lifetyper/smart_line/README.md

就是个通过FT232H芯片，把USB转成SPI、I2C用于硬件调试的小工具，软件使用的是pyftdi。

第一版硬件有点小bug，但实际上使用时并不表现出来。

第二版改成kicad的开源工具了，很难用，所以凑合着用4层板画比较简单，反正嘉立创现在4层板才50块钱。。。。
