lifetyper/smart_line/layout/smart_line_x01_Board_Outline.pdf

ART FILM - Board_Outline

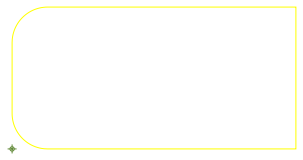
[picture p1: figure]

ART FILM - Board_Outline
