lifetyper/smart_line/layout/smart_line_x01_MASK_BOT.pdf

ART FILM - MASK_BOT

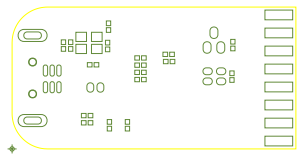
[picture p2: figure]

ART FILM - MASK_BOT
