lifetyper/smart_line/datasheet/adafruit.png

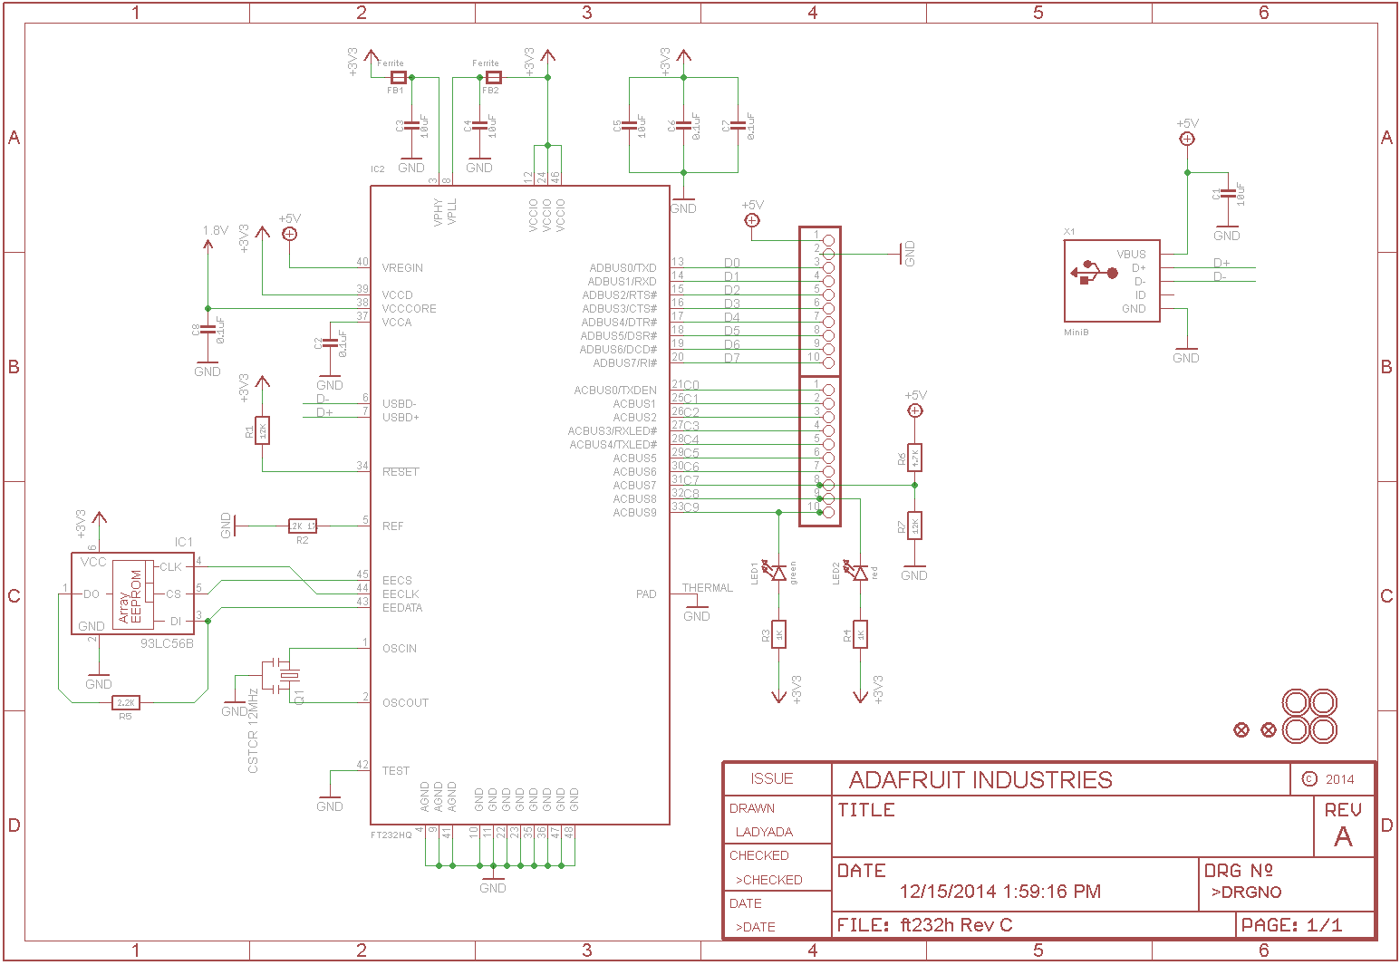
datasheet/adafruit.png
