lifetyper/smart_line/datasheet/MicroUSB.jpg

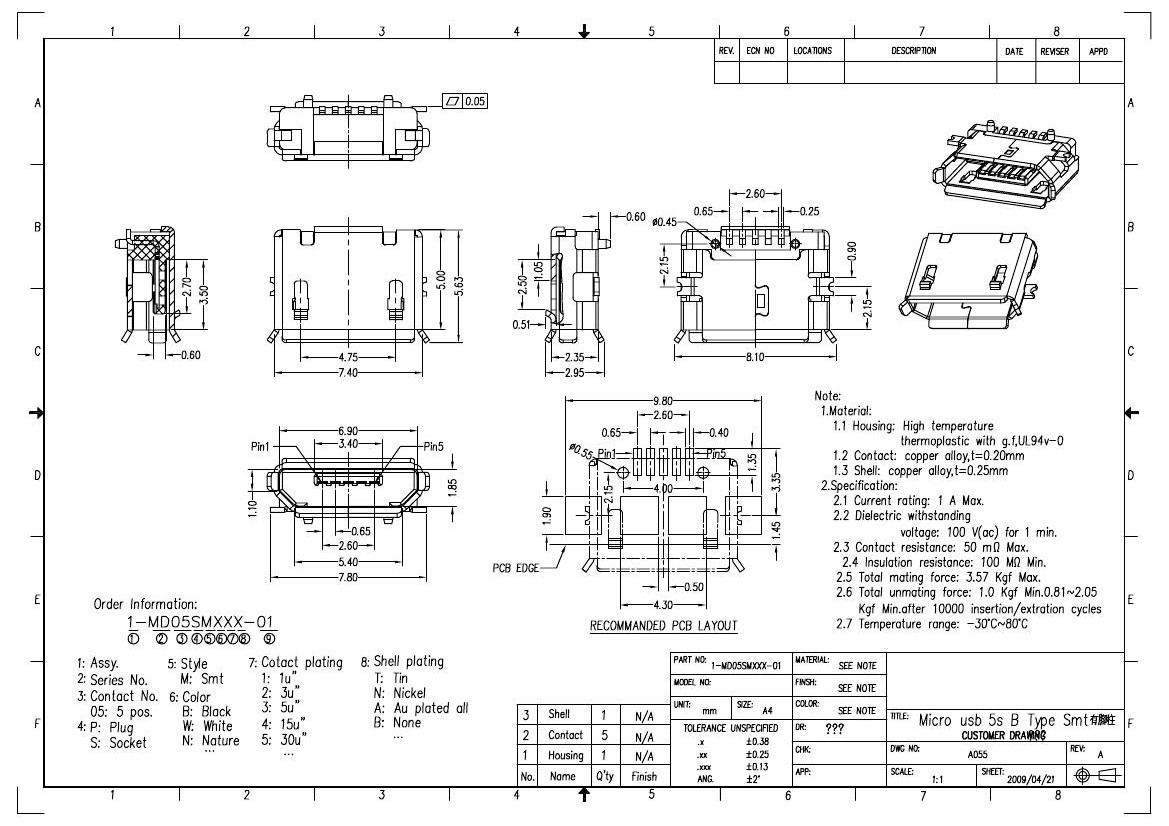
datasheet/MicroUSB.jpg
