lifetyper/smart_line/open_hw/media/qr.bmp

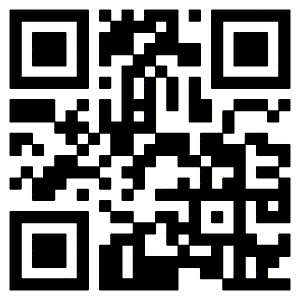
open_hw/media/qr.bmp
