lifetyper/smart_line/open_hw/bom_tool/BOM.xls

Value | Reference | Count | Footprint
100K_0402_5% | R7,R11 | 2 | R_0402
SRV05-4 | U5 | 1 | SOT-23-6
CRYSTAL_3225_4P | X1 | 1 | Crystall_3225_4P
470_0402_5% | R12 | 1 | R_0402
12K_0402_1% | R4 | 1 | R_0402
CONN_01X08 | P3,P2 | 2 | Pin_Header_SMD_1x08
1M_0402_5% | R2 | 1 | R_0402
12P_0402_50V_C0G | C2,C1 | 2 | C_0402
AO3401 | Q2,Q3 | 2 | SOT-23
LED_0603_RED | D1 | 1 | LED_0603
10K_0402_5% | R13,R6,R3,R8 | 4 | R_0402
FUSE | F1 | 1 | Fuse_SMD1206_Reflow
NC | R10,R9 | 2 | R_0402
MMBT3904 | Q1 | 1 | SOT-23
2.2K_0402_5% | R5 | 1 | R_0402
0.1U_0402_16V | C10 | 1 | C_0402
BLM15AG121SN1D | FB3,FB2,FB4 | 3 | C_0402
0.01U_0402_16V_X7R | C8 | 1 | C_0402
TPS73633 | U3 | 1 | SOT-23-5
SN74LVC1G66DRLR_SOT | U4 | 1 | SC-70-5
1U_0402_10V_X7R | C13,C11,C3 | 3 | C_0402
WCM2012 | FB1 | 1 | WCM2012_4P
FT232HL | U1 | 1 | LQFP-48_7x7mm_Pitch0.5mm
0.1U_0402_16V_X7R | C12,C15,C14,C9,C7,C6,C5,C4 | 8 | C_0402
R | R15,R1,R14 | 3 | R_0402
LED_0603_BLUE | D2 | 1 | LED_0603
USB_A_MALE | P1 | 1 | USB_A_SMD
93LC56B | U2 | 1 | SOIC-8_3.9x4.9mm_Pitch1.27mm
