lifetyper/smart_line/SL_V2/sl_v2.xlsx

Designator | Quantity | Comment | Footprint
C13 | 1 | C_0402_1uF_10V_X7R | 0402
C2 | 1 | C_0603_4.7uF_10V_X7R | 0603
C5 | 1 | C_0603_4.7uF_10V_X7R | 0603
C6 C1 C11 C10 C12 C14 C7 C18 C3 C16 C17 C15 C19 C20 | 14 | C_0402_100nF_16V_X7R | 0402
C8 C9 | 2 | C_0402_20pF_50V_C0G | 0402
D1 | 1 | LED | 0603
F1 | 1 | Fuse_1206_500mA | 1206
L2 | 1 | 100_ohm_bead | 0402
L4 L1 L3 | 3 | 100ohm_bead | 0402
Q1 | 1 | AO3401A | SOT-23
Q2 | 1 | FDC6330L | TSOT-23-6
Q3 | 1 | MMBT3904 | SOT-23
R1 R2 | 2 | R_0402_100K_5% | 0402
R10 R11 | 2 | R_0402_0_5% | 0402
R13 | 1 | R_0402_12K_1% | 0402
R14 | 1 | R_0402_1M_5% | 0402
R15 R20 | 2 | R_0402_2.2K_5% | 0402
R16 R23 R22 | 3 | R_0402_10K_5% | 0402
R19 R25 R24 | 3 | R_0402_47K_5% | 0402
R3 R4 R5 R12 R17 R21 R18 | 7 | R_0402_10K_5% | 0402
R6 R7 | 2 | R_0402_5.1K_5% | 0402
R8 R9 | 2 | R_0402_22_5% | 0402
U1 | 1 | TPS73633DBV | SOT-23-5
U2 | 1 | 93LCxxB | SOIC-8
U3 | 1 | FT232H | LQFP-48_7x7mm_P0.5mm
U4 | 1 | 74LVC1G66 | SOT-353
Y1 | 1 | Crystal_GND24_Small | 3225
