lifetyper/smart_line/open_hw/dxf/outline_r12_exploded.dxf

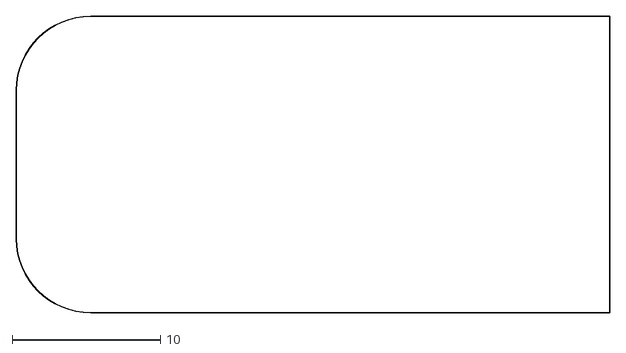
[picture p6: CAD file, 2016-04-14]
open_hw/dxf/outline_r12_exploded.dxf
40.0 x 20.0
