lifetyper/smart_line/open_hw/dxf/margin.dxf

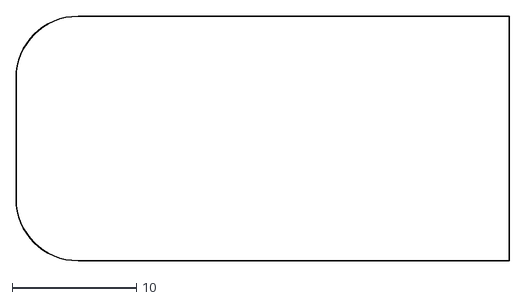
[picture p7: CAD file, 2016-04-14]
open_hw/dxf/margin.dxf
39.7 x 19.7
