lifetyper/smart_line/(list of files, cad)

Other CAD files:
board_outline/X01/ouline.dwg
