lifetyper/smart_line/schematic/x01/smart_line_x01.pdf

# Fix Symbol

# Change Bead Symbol

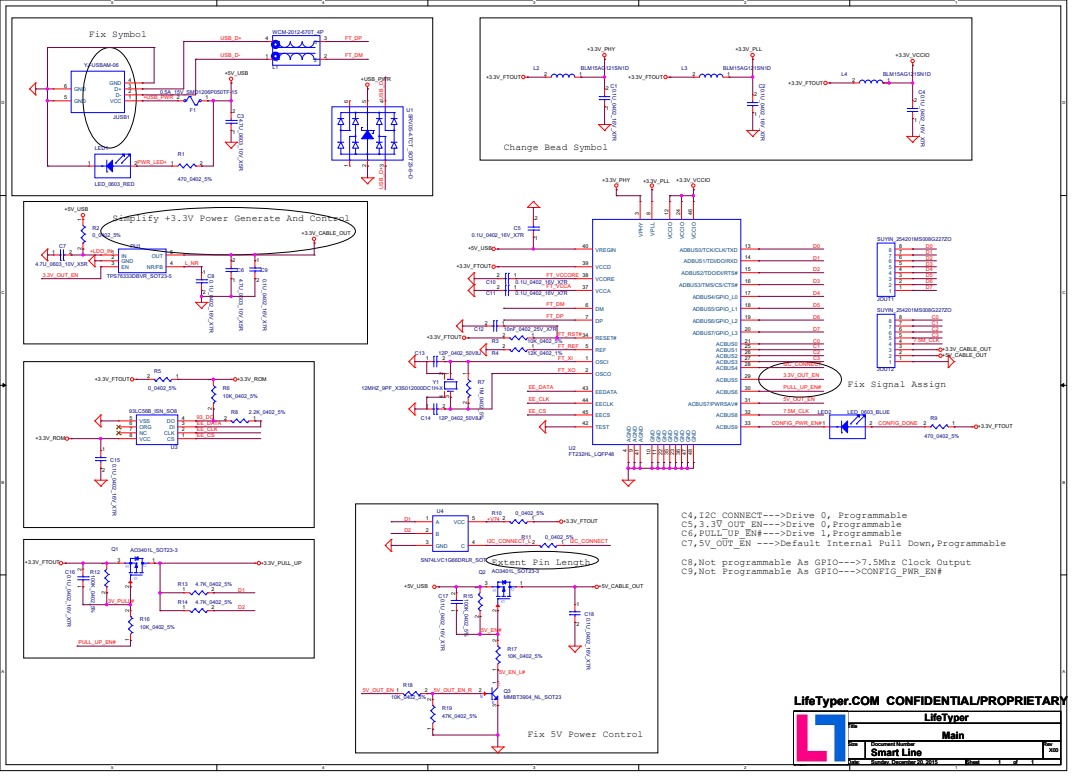
[picture p8: page 1]

JUSB1 YJ-USBAM-06 VCC 1 D- 2 D+ GND 3

9 GND 10 GND 11 VCCIO 12 ADBUS0/TCK/CLK/TXD 13 ADBUS1/TDI/DO/RXD 14 ADBUS2/TDO/DI/RTS# 15 ADBUS3/TMS/CS/CTS# 16 ADBUS4/GPIO_L0 17 ADBUS5/GPIO_L1 18 ADBUS6/GPIO_L2 19 ADBUS7/GPIO_L3 20 ACBUS0 21 GND 22 GND 23 VCCIO 24 ACBUS1 25 ACBUS2 26 ACBUS3 27 ACBUS4 28 ACBUS5 29 ACBUS6 30 ACBUS7/PWRSAV# 31 ACBUS8 32 ACBUS9 33 RESET# 34 GND 35 GND 36 VCCA 37 VCORE 38 VCCD 39 VREGIN 40 AGND 41 TEST 42 EEDATA

C4,I2C_CONNECT--->Drive 0, Programmable
C5,3.3V_OUT_EN--->Drive 0,Programmable
C6,PULL_UP_EN#--->Drive 1,Programmable
C7,5V_OUT_EN --->Default Internal Pull Down,Programmable
C8,Not programmable As GPIO--->7.5Mhz Clock Output
C9,Not Programmable As GPIO--->CONFIG_PWR_EN#

LifeTyper.COM CONFIDENTIAL/PROPRIETARY
