lifetyper/smart_line/layout/smart_line_x01_BOTTOM.pdf

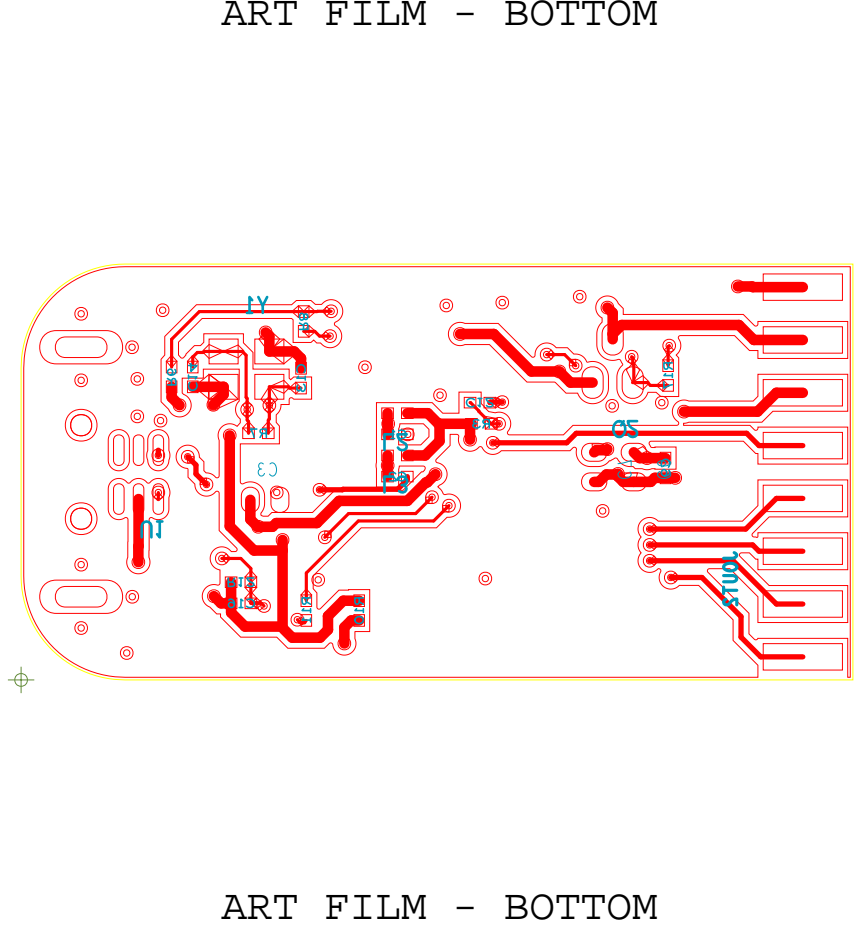
[picture p9: page 1]
