lifetyper/smart_line/layout/smart_line_x01_MASK_TOP.pdf

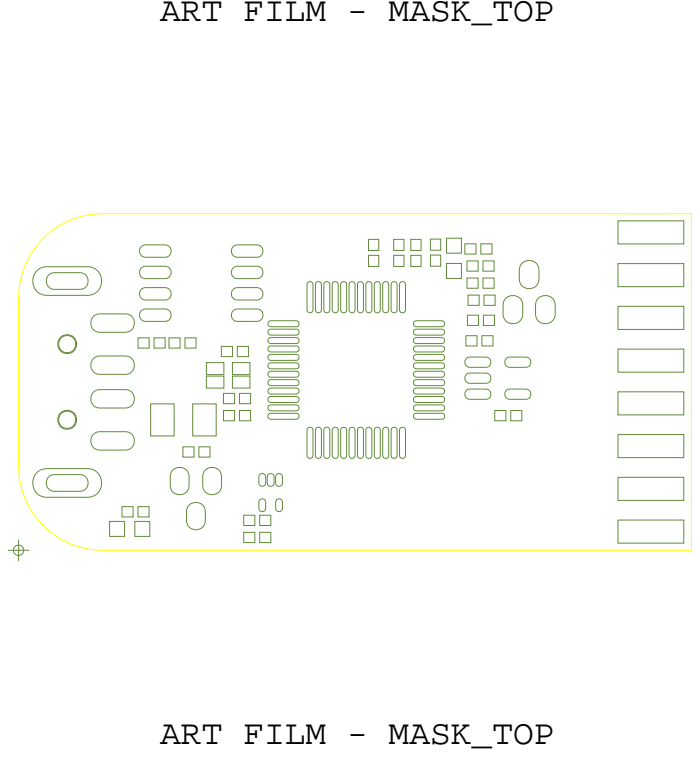
[picture p10: page 1]
ART FILM - MASK_TOP
