lifetyper/smart_line/layout/smart_line_x01_SILK_BOT.pdf

# ART FILM - SILK_BOT

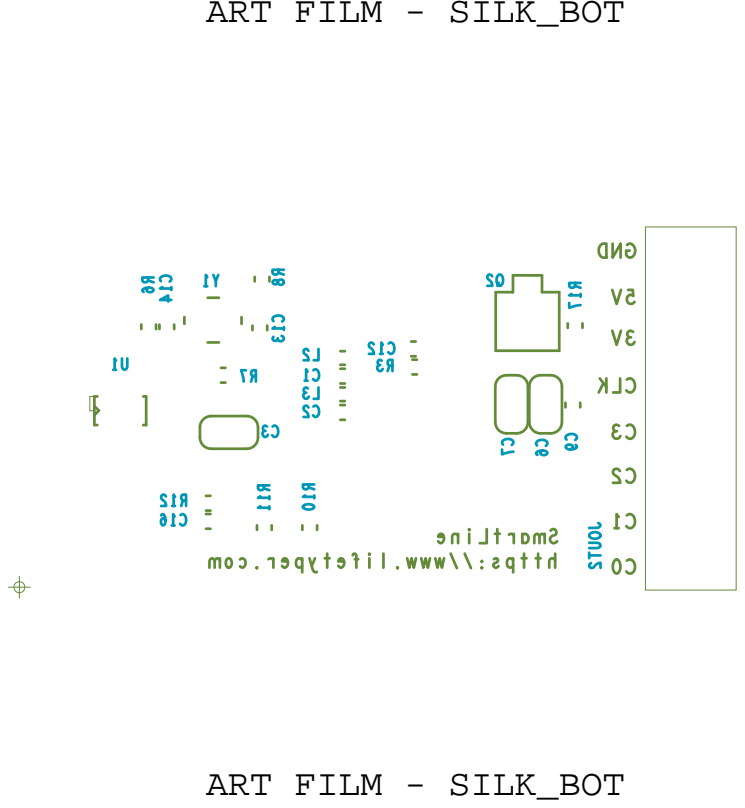
[picture p11: page 1]

https://www.lifetyper.com
