lifetyper/smart_line/layout/smart_line_x01_SILK_TOP.pdf

# ART FILM - SILK_TOP

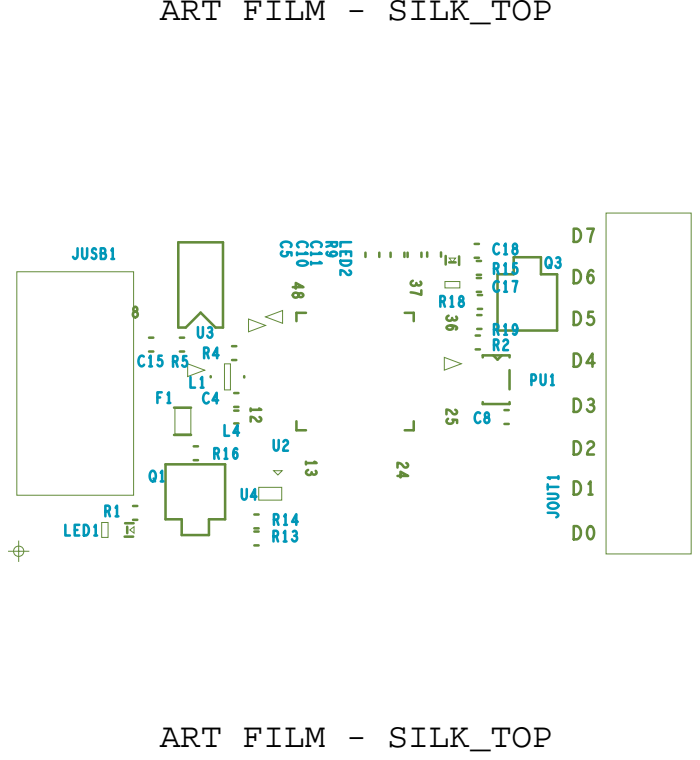
[picture p12: page 1]
