lifetyper/smart_line/layout/smart_line_x01_TOP.pdf

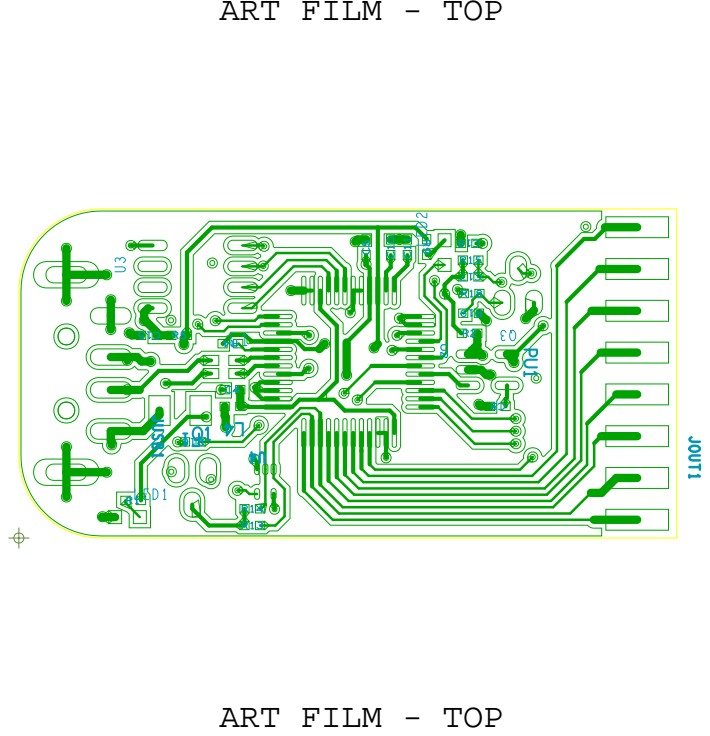
[picture p13: page 1]
