lifetyper/smart_line/open_hw/smartline.kicad_pcb

## KiCad design open_hw/smartline.kicad_pcb (2016-04-14)

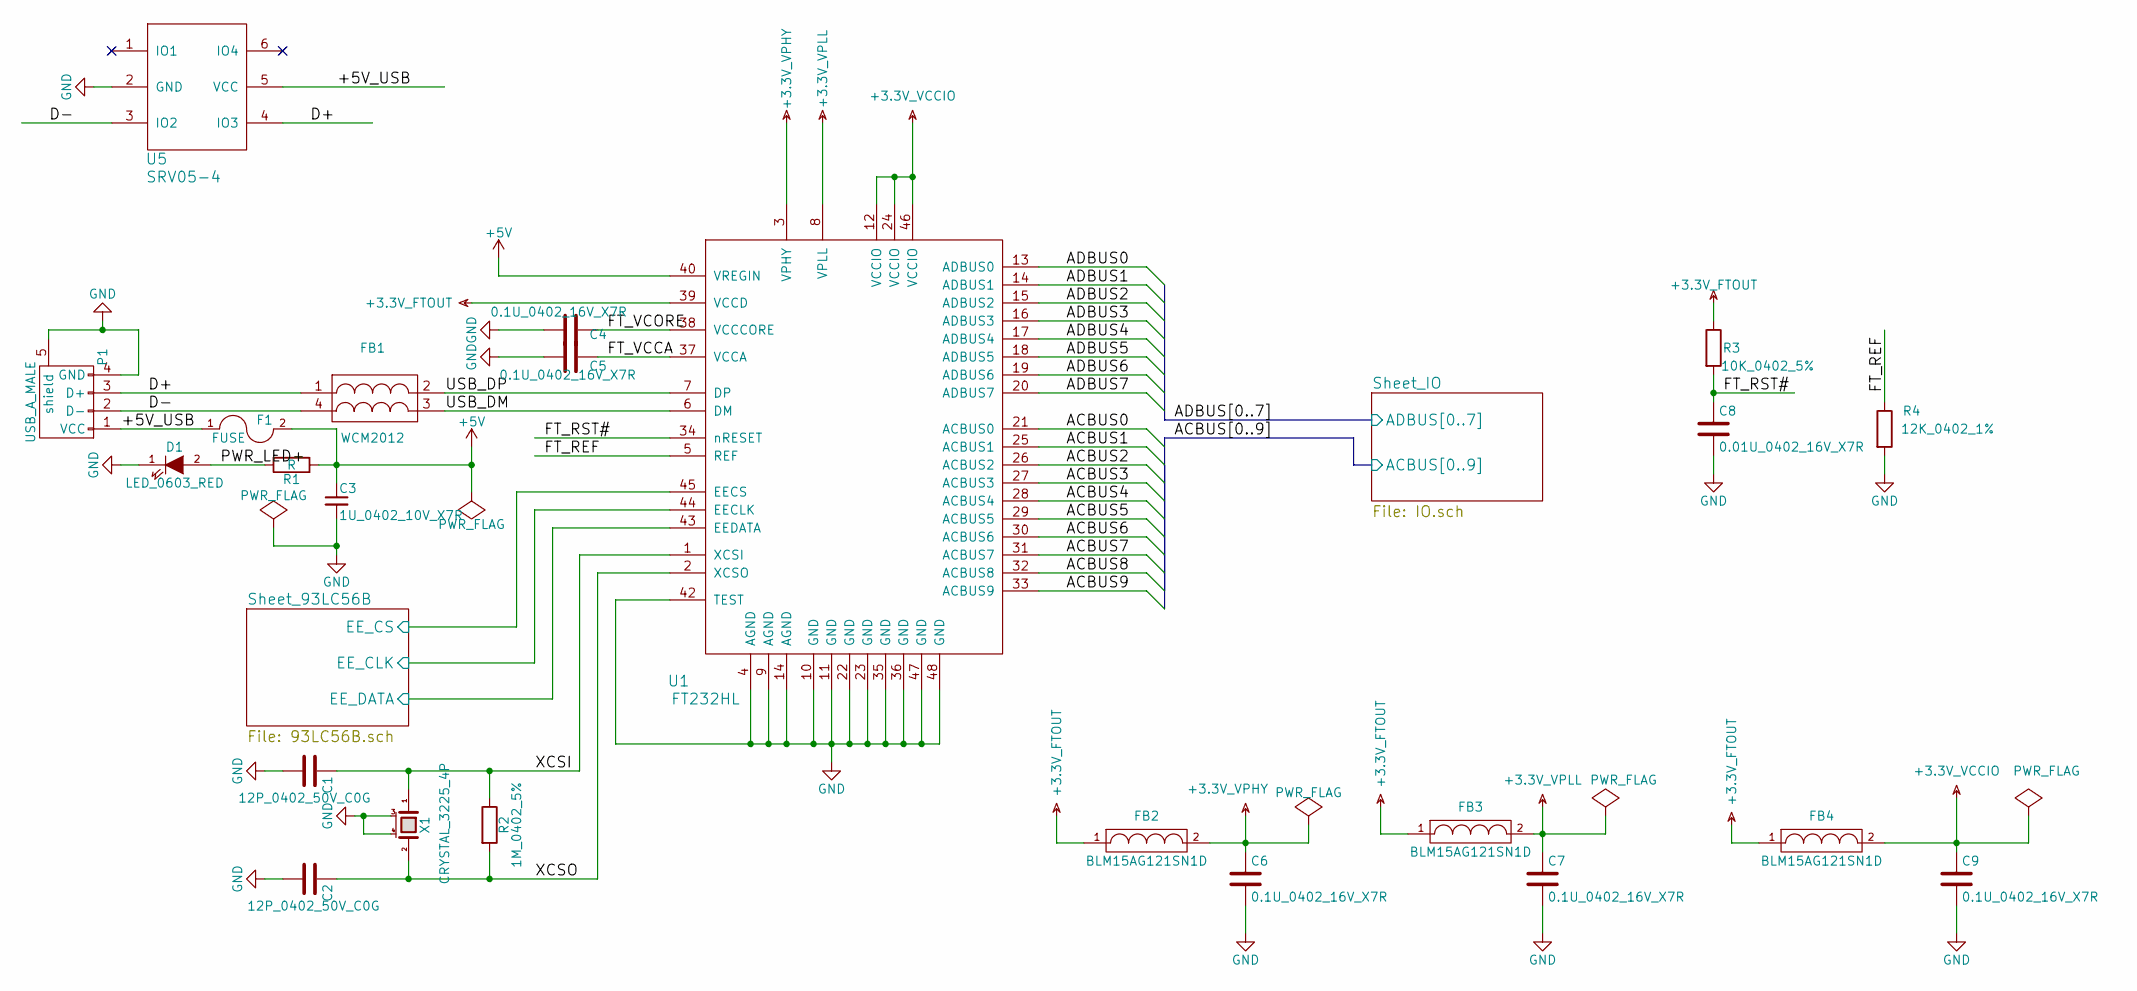
[picture p16: schematic smartline.sch]

Parts:
C1, C2: 12P_0402_50V_C0G; C_0402
C3: 1U_0402_10V_X7R; C_0402
C4, C5, C6, C7, C9: 0.1U_0402_16V_X7R; C_0402
C8: 0.01U_0402_16V_X7R; C_0402
D1: LED_0603_RED; LED_0603
F1: FUSE; Fuse_SMD1206_Reflow
FB1: WCM2012; WCM2012_4P
FB2, FB3, FB4: BLM15AG121SN1D; C_0402
P1: USB_A_MALE; USB_A_SMD
R1: R; R_0402
R2: 1M_0402_5%; R_0402
R3: 10K_0402_5%; R_0402
R4: 12K_0402_1%; R_0402
U1: FT232HL; LQFP-48_7x7mm_Pitch0.5mm
U5: SRV05-4; SOT-23-6
X1: CRYSTAL_3225_4P; Crystall_3225_4P

Connections:
+3.3V_FTOUT: FB2.1, FB3.1, FB4.1, R3.1, U1.39 (VCCD); also elsewhere on the board
+3.3V_VCCIO: C9.1, FB4.2, U1.12 (VCCIO), U1.24 (VCCIO), U1.46 (VCCIO)
+3.3V_VPHY: C6.1, FB2.2, U1.3 (VPHY)
+3.3V_VPLL: C7.1, FB3.2, U1.8 (VPLL)
+5V: C3.1, F1.2, R1.1, U1.40 (VREGIN); also elsewhere on the board
/+5V_USB: F1.1, P1.1 (VCC), U5.5 (VCC)
/ACBUS0: U1.21 (ACBUS0); also elsewhere on the board
/ACBUS1: U1.25 (ACBUS1); also elsewhere on the board
/ACBUS2: U1.26 (ACBUS2); also elsewhere on the board
/ACBUS3: U1.27 (ACBUS3); also elsewhere on the board
/ACBUS4: U1.28 (ACBUS4); also elsewhere on the board
/ACBUS5: U1.29 (ACBUS5); also elsewhere on the board
/ACBUS6: U1.30 (ACBUS6); also elsewhere on the board
/ACBUS7: U1.31 (ACBUS7); also elsewhere on the board
/ACBUS8: U1.32 (ACBUS8); also elsewhere on the board
/ACBUS9: U1.33 (ACBUS9); also elsewhere on the board
/ADBUS0: U1.13 (ADBUS0); also elsewhere on the board
/ADBUS2: U1.15 (ADBUS2); also elsewhere on the board
/ADBUS3: U1.16 (ADBUS3); also elsewhere on the board
/ADBUS4: U1.17 (ADBUS4); also elsewhere on the board
/ADBUS5: U1.18 (ADBUS5); also elsewhere on the board
/ADBUS6: U1.19 (ADBUS6); also elsewhere on the board
/ADBUS7: U1.20 (ADBUS7); also elsewhere on the board
/D+: FB1.1, P1.3 (D+), U5.4 (IO3)
/D-: FB1.4, P1.2 (D-), U5.3 (IO2)
/FT_REF: R4.1, U1.5 (REF)
/FT_RST#: C8.1, R3.2, U1.34 (nRESET)
/FT_VCCA: C5.1, U1.37 (VCCA)
/FT_VCORE: C4.1, U1.38 (VCCCORE)
/PWR_LED+: D1.2 (A), R1.2
/Sheet_93LC56B/EE_CLK: U1.44 (EECLK); also elsewhere on the board
/Sheet_93LC56B/EE_CS: U1.45 (EECS); also elsewhere on the board
/Sheet_93LC56B/EE_DATA: U1.43 (EEDATA); also elsewhere on the board
/USB_DM: FB1.3, U1.6 (DM)
/USB_DP: FB1.2, U1.7 (DP)
/XCSI: C1.1, R2.1, U1.1 (XCSI), X1.1
/XCSO: C2.1, R2.2, U1.2 (XCSO), X1.2

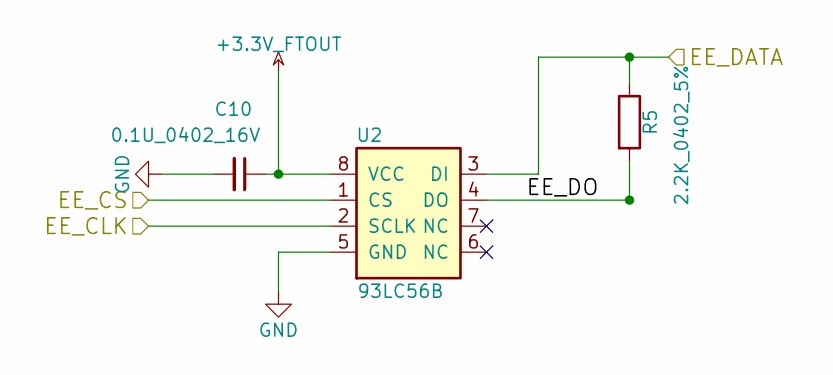
[picture p17: schematic 93LC56B.sch]

Parts:
C10: 0.1U_0402_16V; C_0402
R5: 2.2K_0402_5%; R_0402
U2: 93LC56B; SOIC-8_3.9x4.9mm_Pitch1.27mm

Connections:
+3.3V_FTOUT: C10.1, U2.8 (VCC); also elsewhere on the board
/Sheet_93LC56B/EE_CLK: U2.2 (SCLK); also elsewhere on the board
/Sheet_93LC56B/EE_CS: U2.1 (CS); also elsewhere on the board
/Sheet_93LC56B/EE_DATA: R5.1, U2.3 (DI); also elsewhere on the board
/Sheet_93LC56B/EE_DO: R5.2, U2.4 (DO)

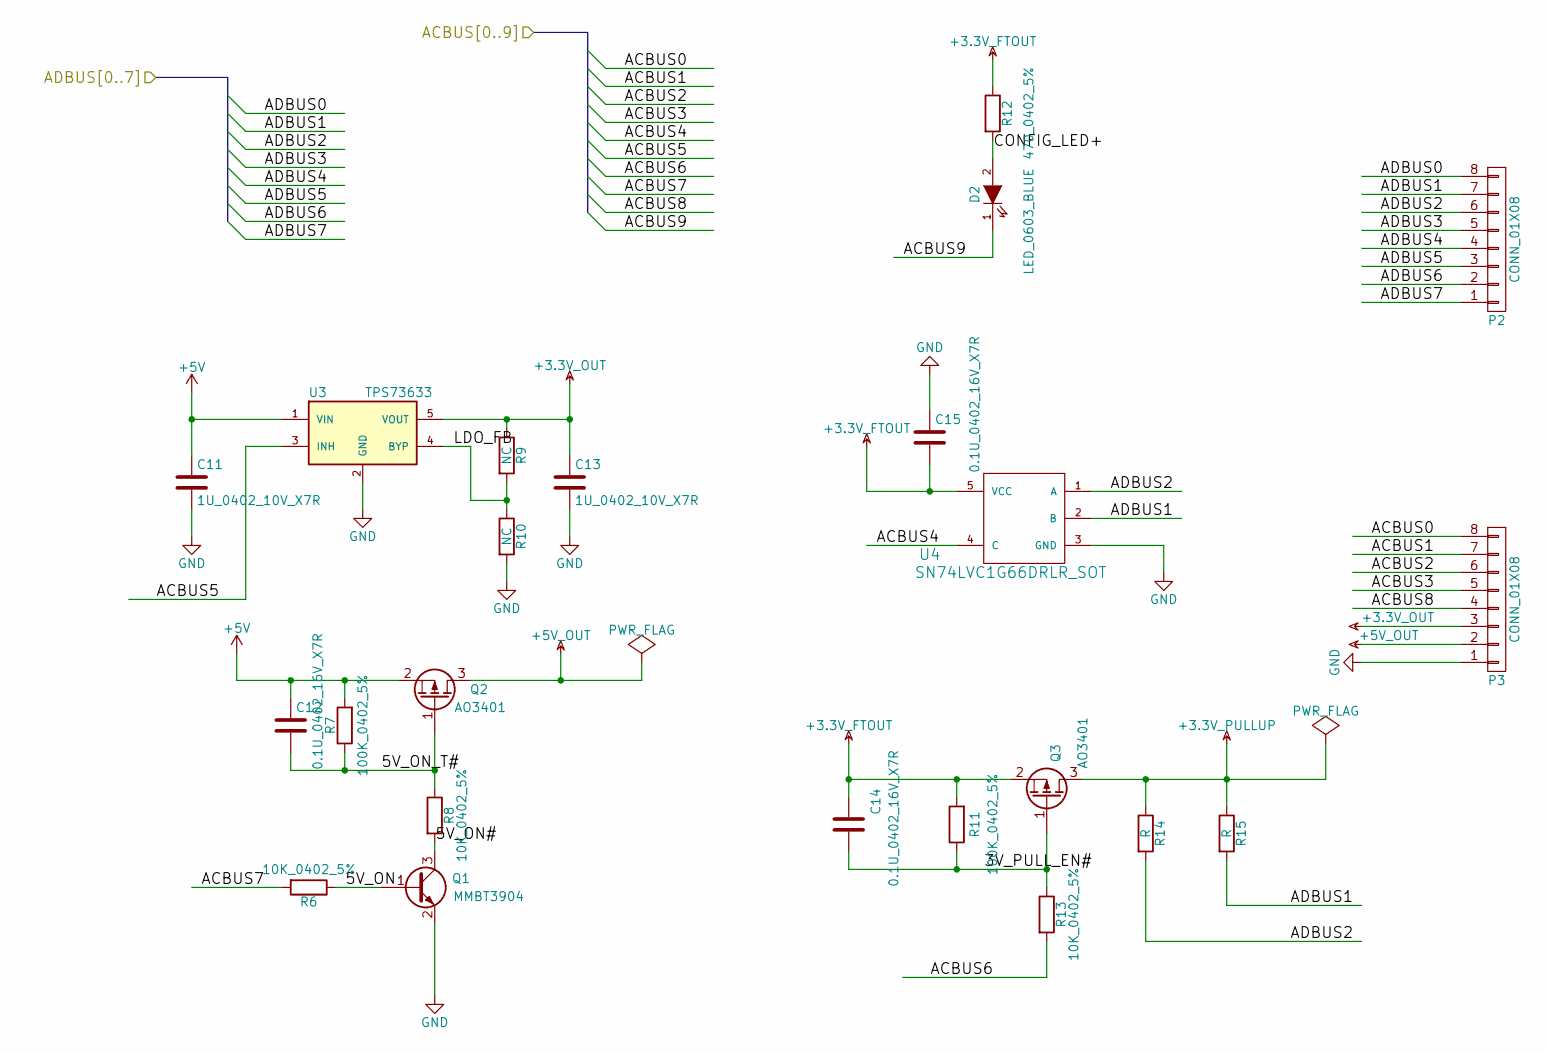
[picture p18: schematic IO.sch]

Parts:
C11, C13: 1U_0402_10V_X7R; C_0402
C12, C14, C15: 0.1U_0402_16V_X7R; C_0402
D2: LED_0603_BLUE; LED_0603
P2, P3: CONN_01X08; Pin_Header_SMD_1x08
Q1: MMBT3904; SOT-23
Q2, Q3: AO3401; SOT-23
R6, R8, R13: 10K_0402_5%; R_0402
R7, R11: 100K_0402_5%; R_0402
R9, R10: NC; R_0402
R12: 470_0402_5%; R_0402
R14, R15: R; R_0402
U3: TPS73633; SOT-23-5
U4: SN74LVC1G66DRLR_SOT; SC-70-5

Connections:
+3.3V_FTOUT: C14.1, C15.2, Q3.2 (S), R11.2, R12.1, U4.5 (VCC); also elsewhere on the board
+3.3V_OUT: C13.1, P3.3, R9.1, U3.5 (VOUT)
+3.3V_PULLUP: Q3.3 (D), R14.1, R15.1
+5V: C11.1, C12.1, Q2.2 (S), R7.2, U3.1 (VIN); also elsewhere on the board
+5V_OUT: P3.2, Q2.3 (D)
/ACBUS0: P3.8; also elsewhere on the board
/ACBUS1: P3.7; also elsewhere on the board
/ACBUS2: P3.6; also elsewhere on the board
/ACBUS3: P3.5; also elsewhere on the board
/ACBUS4: U4.4 (C); also elsewhere on the board
/ACBUS5: U3.3 (INH); also elsewhere on the board
/ACBUS6: R13.2; also elsewhere on the board
/ACBUS7: R6.2; also elsewhere on the board
/ACBUS8: P3.4; also elsewhere on the board
/ACBUS9: D2.1 (K); also elsewhere on the board
/ADBUS0: P2.8; also elsewhere on the board
/ADBUS2: P2.6, R14.2, U4.1 (A); also elsewhere on the board
/ADBUS3: P2.5; also elsewhere on the board
/ADBUS4: P2.4; also elsewhere on the board
/ADBUS5: P2.3; also elsewhere on the board
/ADBUS6: P2.2; also elsewhere on the board
/ADBUS7: P2.1; also elsewhere on the board
/Sheet_IO/3V_PULL_EN#: C14.2, Q3.1 (G), R11.1, R13.1
/Sheet_IO/5V_ON: Q1.1 (B), R6.1
/Sheet_IO/5V_ON#: Q1.3 (C), R8.2
/Sheet_IO/5V_ON_T#: C12.2, Q2.1 (G), R7.1, R8.1
/Sheet_IO/CONFIG_LED+: D2.2 (A), R12.2
/Sheet_IO/LDO_FB: R9.2, R10.1, U3.4 (BYP)

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
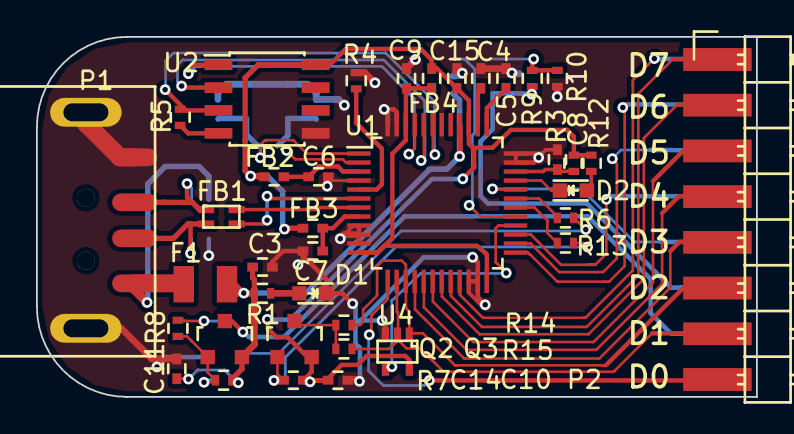
[picture p19: board smartline.kicad_pcb from above]

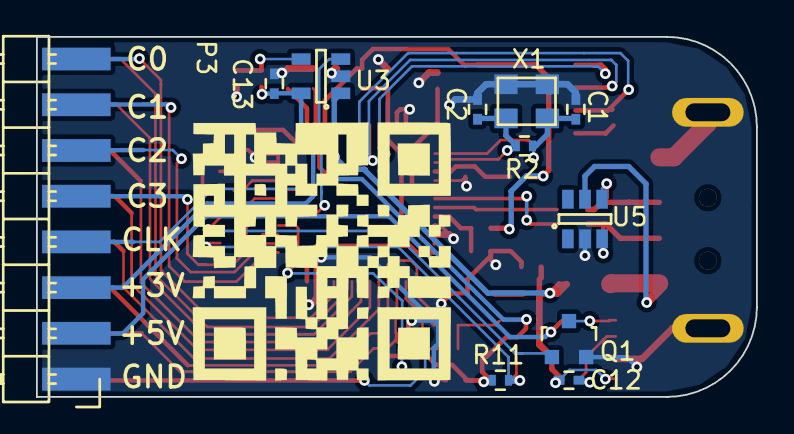
[picture p20: board smartline.kicad_pcb from below]

Board: 2 copper layers, 40.0 x 20.0 mm, 49 parts (11 on the bottom side), 49 nets.
