lifetyper/smart_line/SL_V2/sl_v2.sch

## KiCad design SL_V2/sl_v2.sch (2020-08-19, an earlier design)


Parts:
C1, C3, C6, C7, C10, C11, C12, C14, C15, C16, C17, C18, C19, C20: C_0402_100nF_16V_X7R; C_0402_1005Metric
C2, C5: C_0603_4.7uF_10V_X7R; C_0603_1608Metric
C4: NC; C_0402_1005Metric
C8, C9: C_0402_20pF_50V_C0G; C_0402_1005Metric
C13: C_0402_1uF_10V_X7R; C_0402_1005Metric
D1: LED; LED_0603_1608Metric
F1: Fuse_1206_500mA; Fuse_1206_3216Metric
J1: USB_C_Receptacle_USB2.0; USB_C_Receptacle_HRO_TYPE-C-31-M-12
J2: Conn_02x08_Top_Bottom; Connector_02X08_SMD_C
L1, L2, L3, L4: 100ohm_bead; L_0402_1005Metric
Q1: AO3401A; SOT-23
Q2: FDC6330L; TSOT-23-6
Q3: MMBT3904; SOT-23
R1, R2: R_0402_100K_5%; R_0402_1005Metric
R3, R4, R5, R12, R17, R18, R21, R22, R23: R_0402_10K_5%; R_0402_1005Metric
R6, R7: R_0402_5.1K_5%; R_0402_1005Metric
R8, R9: R_0402_22_5%; R_0402_1005Metric
R10, R11: R_0402_0_5%; R_0402_1005Metric
R13: R_0402_12K_1%; R_0402_1005Metric
R14: R_0402_1M_5%; R_0402_1005Metric
R15, R20: R_0402_2.2K_5%; R_0402_1005Metric
R16: R_040210K_5%; R_0402_1005Metric
R19, R24, R25: R_0402_47K_5%; R_0402_1005Metric
U1: TPS73633DBV; SOT-23-5
U2: 93LCxxB; SOIC-8_3.9x4.9mm_P1.27mm
U3: FT232H; LQFP-48_7x7mm_P0.5mm
U4: 74LVC1G66; SOT-353_SC-70-5
Y1: Crystal_GND24_Small; Oscillator_SMD_EuroQuartz_XO32-4Pin_3.2x2.5mm

Connections:
3.3V_OUT: J2.14
3.3V_OUT_EN: R2.1, U1.3 (EN), U3.29 (ACBUS5)
5V_EN: Q2.5 (G1), R17.1, R19.2
5V_OUT: J2.15
5V_OUT_EN: R17.2, U3.31 (ACBUS7)
7.5M_CLK: J2.13, U3.32 (ACBUS8)
+3.3V_FTOUT: C1.2, L1.1, L2.1, L3.1, L4.1, Q1.2 (S), R1.1, R11.2, R12.2, R20.1, U3.39 (VCCD)
+3.3V_OUT: R10.1
+3.3V_PHY: C7.2, L2.2, U3.3 (VPHY)
+3.3V_PLL: C18.2, L4.2, U3.8 (VPLL)
+3.3V_PU: Q1.3 (D), R4.2, R5.2
+3.3V_RAW: C5.1, C6.1, R10.2, U1.5 (OUT)
+3.3V_ROM: C14.2, R11.1, R16.1, R22.2, R23.1, U2.8 (VCC)
+3.3V_VCCIO: C3.2, C19.2, C20.2, L1.2, U3.12 (VCCIO), U3.24 (VCCIO), U3.46 (VCCIO)
+5V_OUT: C17.2, Q2.2 (D2), Q2.3 (D2)
C0: J2.9, U3.21 (ACBUS0)
C1: J2.10, U3.25 (ACBUS1)
C2: J2.11, U3.26 (ACBUS2)
C3: J2.12, U3.27 (ACBUS3)
CONFIG_DONE: D1.2 (A), R20.2
CONFIG_DONE#: D1.1 (K), U3.33 (ACBUS9)
D0: J2.1, R4.1, U3.13 (ADBUS0)
D1: J2.2, R5.1, U3.14 (ADBUS1), U4.1
D2: J2.3, U3.15 (ADBUS2), U4.2
D3: J2.4, U3.16 (ADBUS3)
D4: J2.5, U3.17 (ADBUS4)
D5: J2.6, U3.18 (ADBUS5)
D6: J2.7, U3.19 (ADBUS6)
D7: J2.8, U3.20 (ADBUS7)
D+: J1.A6 (D+), J1.B6 (D+), R9.2
D-: J1.A7 (D-), J1.B7 (D-), R8.2
DM: R8.1, U3.6 (DM)
DP: R9.1, U3.7 (DP)
EE_CLK: R23.2, U2.2 (SCLK), U3.44 (EECLK)
EE_CS: R22.1, U2.1 (CS), U3.45 (EECS)
EE_DATA: R15.1, U2.3 (DI), U3.43 (EEDATA)
FT_RST: C12.2, R12.1, U3.34 (~RESET)
GND: C2.1, C3.1, C4.2, C5.2, C6.2, C7.1, C8.1, C9.1, C10.2, C11.2, C12.1, C13.1, C14.1, C15.2, C17.1, C18.1, C19.1, C20.1, J1.A1 (GND), J1.A12 (GND), J1.B1 (GND), J1.B12 (GND), J1.S1 (SHIELD), J2.16, Q3.2 (E), R2.2, R6.1, R7.1, R13.2, R19.1, R21.1, R25.2, U1.2 (GND), U2.5 (GND), U3.4 (AGND), U3.9 (AGND), U3.10 (GND), U3.11 (GND), U3.22 (GND), U3.23 (GND), U3.35 (GND), U3.36 (GND), U3.41 (AGND), U3.42 (TEST), U3.47 (GND), U3.48 (GND), U4.3 (GND), Y1.2, Y1.4
I2C_CONNECT: R24.1, U3.28 (ACBUS4), U4.4
unnamed: C4.1, U1.4 (NR)
unnamed: C8.2, R14.2, U3.1 (XCSI), Y1.1
unnamed: C9.2, R14.1, U3.2 (XCSO), Y1.3
unnamed: C10.1, U3.38 (VCCCORE)
unnamed: C11.1, U3.37 (VCCA)
unnamed: C15.1, L3.2, U4.5 (VCC)
unnamed: C16.1, Q2.6 (D1), R18.1
unnamed: J1.A5 (CC1), R6.2
unnamed: J1.B5 (CC2), R7.2
unnamed: Q2.1 (S1), R21.2
unnamed: Q3.1 (B), R24.2, R25.1
unnamed: Q3.3 (C), R3.1
unnamed: R13.1, U3.5 (REF)
unnamed: R15.2, R16.2, U2.4 (DO)
PU_EN#: C1.1, Q1.1 (G), R1.2, R3.2
VBUS_5V: C2.2, C13.2, C16.2, F1.2, Q2.4 (S2), R18.2, U1.1 (IN), U3.40 (VREGIN)
VBUS_RAW: F1.1, J1.A4 (VBUS), J1.A9 (VBUS), J1.B4 (VBUS), J1.B9 (VBUS)
