lifetyper/smart_line/open_hw/93LC56B.sch

## KiCad design open_hw/93LC56B.sch (2016-04-14)


Parts:
C10: 0.1U_0402_16V; C_0402
R5: 2.2K_0402_5%; R_0402
U2: 93LC56B; SOIC-8_3.9x4.9mm_Pitch1.27mm

Connections:
+3.3V_FTOUT: C10.1, U2.8 (VCC)
EE_CLK: U2.2 (SCLK)
EE_CS: U2.1 (CS)
EE_DATA: R5.1, U2.3 (DI)
EE_DO: R5.2, U2.4 (DO)
GND: C10.2, U2.5 (GND)
