lifetyper/smart_line/open_hw/IO.sch

## KiCad design open_hw/IO.sch (2016-04-14)


Parts:
C11, C13: 1U_0402_10V_X7R; C_0402
C12, C14, C15: 0.1U_0402_16V_X7R; C_0402
D2: LED_0603_BLUE; LED_0603
P2, P3: CONN_01X08; Pin_Header_SMD_1x08
Q1: MMBT3904; SOT-23
Q2, Q3: AO3401; SOT-23
R6, R8, R13: 10K_0402_5%; R_0402
R7, R11: 100K_0402_5%; R_0402
R9, R10: NC; R_0402
R12: 470_0402_5%; R_0402
R14, R15: R; R_0402
U3: TPS73633; SOT-23-5
U4: SN74LVC1G66DRLR_SOT; SC-70-5

Connections:
3V_PULL_EN#: C14.2, Q3.1 (G), R11.1, R13.1
5V_ON: Q1.1 (B), R6.1
5V_ON#: Q1.3 (C), R8.2
5V_ON_T#: C12.2, Q2.1 (G), R7.1, R8.1
+3.3V_FTOUT: C14.1, C15.2, Q3.2 (S), R11.2, R12.1, U4.5 (VCC)
+3.3V_OUT: C13.1, P3.3, R9.1, U3.5 (VOUT)
+3.3V_PULLUP: Q3.3 (D), R14.1, R15.1
+5V: C11.1, C12.1, Q2.2 (S), R7.2, U3.1 (VIN)
+5V_OUT: P3.2, Q2.3 (D)
ACBUS0: P3.8
ACBUS1: P3.7
ACBUS2: P3.6
ACBUS3: P3.5
ACBUS4: U4.4 (C)
ACBUS5: U3.3 (INH)
ACBUS6: R13.2
ACBUS7: R6.2
ACBUS8: P3.4
ACBUS9: D2.1 (K)
ADBUS0: P2.8
ADBUS1: P2.7, R15.2, U4.2 (B)
ADBUS2: P2.6, R14.2, U4.1 (A)
ADBUS3: P2.5
ADBUS4: P2.4
ADBUS5: P2.3
ADBUS6: P2.2
ADBUS7: P2.1
CONFIG_LED+: D2.2 (A), R12.2
GND: C11.2, C13.2, C15.1, P3.1, Q1.2 (E), R10.2, U3.2 (GND), U4.3 (GND)
LDO_FB: R9.2, R10.1, U3.4 (BYP)
