lifetyper/smart_line/open_hw/smartline.sch

## KiCad design open_hw/smartline.sch (2016-04-14)


Parts:
C1, C2: 12P_0402_50V_C0G; C_0402
C3: 1U_0402_10V_X7R; C_0402
C4, C5, C6, C7, C9: 0.1U_0402_16V_X7R; C_0402
C8: 0.01U_0402_16V_X7R; C_0402
D1: LED_0603_RED; LED_0603
F1: FUSE; Fuse_SMD1206_Reflow
FB1: WCM2012; WCM2012_4P
FB2, FB3, FB4: BLM15AG121SN1D; C_0402
P1: USB_A_MALE; USB_A_SMD
R1: R; R_0402
R2: 1M_0402_5%; R_0402
R3: 10K_0402_5%; R_0402
R4: 12K_0402_1%; R_0402
U1: FT232HL; LQFP-48_7x7mm_Pitch0.5mm
U5: SRV05-4; SOT-23-6
X1: CRYSTAL_3225_4P; Crystall_3225_4P

Connections:
+3.3V_FTOUT: FB2.1, FB3.1, FB4.1, R3.1, U1.39 (VCCD)
+3.3V_VCCIO: C9.1, FB4.2, U1.12 (VCCIO), U1.24 (VCCIO), U1.46 (VCCIO)
+3.3V_VPHY: C6.1, FB2.2, U1.3 (VPHY)
+3.3V_VPLL: C7.1, FB3.2, U1.8 (VPLL)
+5V: C3.1, F1.2, R1.1, U1.40 (VREGIN)
+5V_USB: F1.1, P1.1 (VCC), U5.5 (VCC)
ACBUS0: U1.21 (ACBUS0)
ACBUS1: U1.25 (ACBUS1)
ACBUS2: U1.26 (ACBUS2)
ACBUS3: U1.27 (ACBUS3)
ACBUS4: U1.28 (ACBUS4)
ACBUS5: U1.29 (ACBUS5)
ACBUS6: U1.30 (ACBUS6)
ACBUS7: U1.31 (ACBUS7)
ACBUS8: U1.32 (ACBUS8)
ACBUS9: U1.33 (ACBUS9)
ADBUS0: U1.13 (ADBUS0)
ADBUS1: U1.14 (ADBUS1)
ADBUS2: U1.15 (ADBUS2)
ADBUS3: U1.16 (ADBUS3)
ADBUS4: U1.17 (ADBUS4)
ADBUS5: U1.18 (ADBUS5)
ADBUS6: U1.19 (ADBUS6)
ADBUS7: U1.20 (ADBUS7)
D+: FB1.1, P1.3 (D+), U5.4 (IO3)
D-: FB1.4, P1.2 (D-), U5.3 (IO2)
EE_CLK: U1.44 (EECLK)
EE_CS: U1.45 (EECS)
EE_DATA: U1.43 (EEDATA)
FT_REF: R4.1, U1.5 (REF)
FT_RST#: C8.1, R3.2, U1.34 (nRESET)
FT_VCCA: C5.1, U1.37 (VCCA)
FT_VCORE: C4.1, U1.38 (VCCCORE)
GND: C1.2, C2.2, C3.2, C4.2, C5.2, C6.2, C7.2, C8.2, C9.2, D1.1 (K), P1.4 (GND), P1.5 (shield), R4.2, U1.4 (AGND), U1.9 (AGND), U1.10 (GND), U1.11 (GND), U1.14 (ADBUS1), U1.22 (GND), U1.23 (GND), U1.35 (GND), U1.36 (GND), U1.42 (TEST), U1.47 (GND), U1.48 (GND), U5.2 (GND), X1.3 (case), X1.4 (GND)
PWR_LED+: D1.2 (A), R1.2
USB_DM: FB1.3, U1.6 (DM)
USB_DP: FB1.2, U1.7 (DP)
XCSI: C1.1, R2.1, U1.1 (XCSI), X1.1
XCSO: C2.1, R2.2, U1.2 (XCSO), X1.2
