lifetyper/smart_line/(commit log)

2015-12-28 Init
    Nothing
    [ouline.dwg]
2015-12-28 add bom
2016-01-07 fix for x01 hardware io config
    [i2c_scan.py]
2016-01-25 add open hardware version
    [93LC56B.sch, BOM.xls, IO.sch, margin.dxf, outline_r12_exploded.dxf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]
2016-01-25 fix:move back ft232hl
    [smartline-B.Cu.gbr, smartline-B.Mask.gbr, smartline-B.SilkS.gbr, smartline-Edge.Cuts.gbr, smartline-F.Cu.gbr, smartline-F.Mask.gbr, smartline-F.SilkS.gbr, smartline.drl]
2016-01-25 change zone fill to full hatch
    [smartline-B.Cu.gbr, smartline-B.Mask.gbr, smartline-B.SilkS.gbr, smartline-Edge.Cuts.gbr, smartline-F.Cu.gbr, smartline-F.Mask.gbr, smartline-F.SilkS.gbr, smartline.drl]
2016-01-25 Revert "0125_gerber_out"
    This reverts commit b63fd5105e898909c3a391913cbdba684720f112.
    [smartline.kicad_pcb]
2016-01-25 increase text size to 1mm*1mm
    [smartline-B.Cu.gbr, smartline-B.Mask.gbr, smartline-B.SilkS.gbr, smartline-Edge.Cuts.gbr, smartline-F.Cu.gbr, smartline-F.Mask.gbr, smartline-F.SilkS.gbr, smartline.drl]
2020-08-15 add full opensource verion hardware SL_V2
    [sl_v2-B_Mask.gbr, sl_v2-B_Paste.gbr, sl_v2-B_SilkS.gbr, sl_v2-Bottom_Cu.gbr, sl_v2-Edge_Cuts.gbr, sl_v2-F_Mask.gbr, sl_v2-F_Paste.gbr, sl_v2-F_SilkS.gbr]
2020-08-19 fix sl v2 connection
    [sl_v2-B_Mask.gbr, sl_v2-B_Paste.gbr, sl_v2-B_SilkS.gbr, sl_v2-Bottom_Cu.gbr, sl_v2-Edge_Cuts.gbr, sl_v2-F_Mask.gbr, sl_v2-F_Paste.gbr, sl_v2-F_SilkS.gbr]
